BM-labs/kicad_lib/README.md

# my_kicad_lib
Collection of custom made kicad symbols and footprints

 - ESP32-C3FN4
