BM-labs/kicad_lib/(commit log)

2022-01-17 add conn_uSD footprint and symbol
2022-01-17 migrated to kicad 6
2022-01-17 added sod-123 diode footprint
2022-01-20 rj socket added
2022-01-23 usb footprint added
2022-01-28 DRC and footprint fixed
2022-01-29 added esp32-c3FN4
2022-04-30 connector added
2022-05-03 kicad5 libs removed
2022-12-30 sk68xx footprint added
2023-02-06 battery and btn added
